indoor-industry/bike_voltage_regulator-rectifier/jlcpcb/production_files/BOM-bike_voltage_regulator-rectifier.csv

Comment | Designator | Footprint | LCSC | Quantity
0805G_(Green) | LED1 | LED0805-R-RD | C2297 | 1
100nF | C3,C4 | C_0805 | C28233 | 2
10kΩ | R3,R4 | R_0805 | C17414 | 2
10Ω | R13,R7 | R_0805 | C17415 | 2
17-21SUYC/TR8 | LED2 | LED0805-R-RD | C2296 | 1
2200uF_35V_16X25 | C1,C2 | CAP-TH_BD16.0-P7.50-D1.2-FD | C2763 | 2
22kΩ | R8 | R_0805 | C17560 | 1
22nF | C5 | C_0805 | C1729 | 1
3.3kΩ | R1 | R_0805 | C26010 | 1
4.7kΩ | R12,R6 | R_0805 | C17673 | 2
470kΩ | R10 | R_0805 | C17709 | 1
5.1kΩ | R11,R9 | R_0805 | C27834 | 2
BZT52C16-TP | D3 | SOD-123_L2.8-W1.8-LS3.7-RD | C668894 | 1
IRFB4110PBF | U2,U9 | TO-220-3_L10.0-W4.5-P2.54-L | C2650 | 2
LM2903DRG4 | U4 | SOIC-8_L5.0-W4.0-P1.27-LS6.0-BL | C7549 | 1
MBR2045CT_C173461 | U3 | TO-220AB-3_L10.4-W4.6-P2.54-T | C173461 | 1
MMBT3904 | U6 | SOT-23-3_L2.9-W1.3-P1.90-LS2.4-BR | C20526 | 1
MMBT3906LT1G | U7 | SOT-23-3_L2.9-W1.3-P1.90-LS2.4-BR | C53444 | 1
SMCJ16A-E3/57T | D1 | SMC_L6.9-W5.9-LS7.9-RD | C1976569 | 1
TL431BQDBZR | U1 | SOT-23-3_L2.9-W1.6-P1.90-LS2.8-BR | C190245 | 1
