indoor-industry/bike_voltage_regulator-rectifier/bike_voltage_regulator-rectifier.step

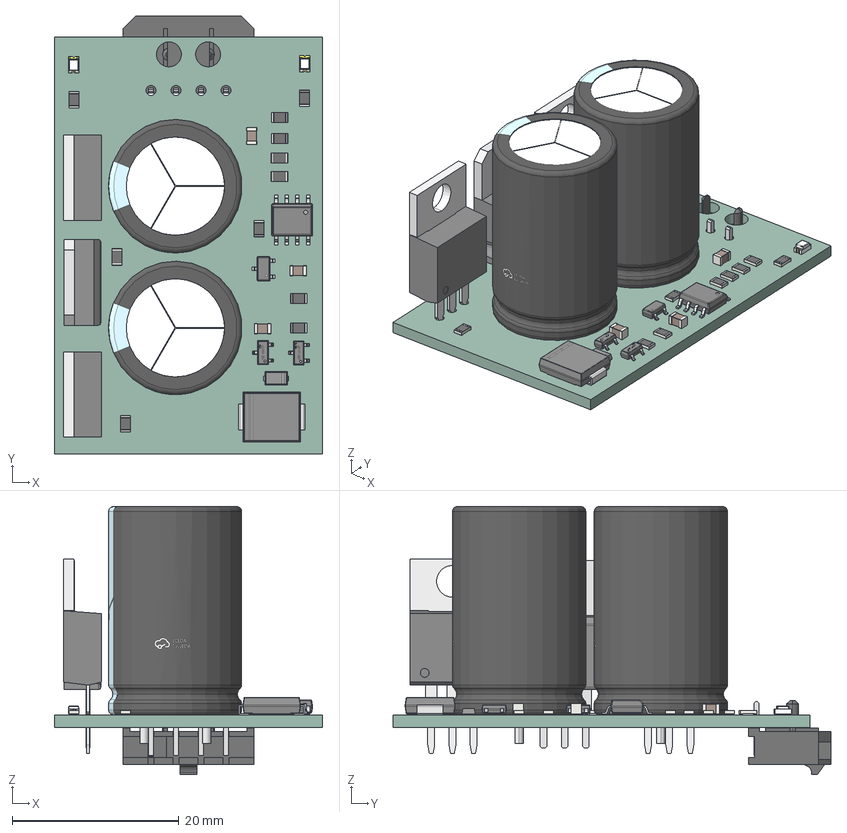
[picture p1: CAD file, 2026-10-28]
bike_voltage_regulator-rectifier.step
32.1 x 52.5 x 32.2 mm
R_0805_2012Metric x 11
SOT-23-3P_L2.9-W1.3-H1.0-LS2.4-P0.95 x 2
C_0805_2012Metric x 3
CAP-TH_D16.0-H25.0-P7.50 x 2
TO-220-3_L10.0-W4.5-P2.54-L x 2
SOIC-8_L4.9-W3.9-H1.7-LS6.0-P1.27
SMC_L6.9-W5.9-LS7.9-RD
LED0805-RD x 2
SOT-23-3L_L2.9-W1.6-H1.1-LS2.8-P0.95
SOD-123_L2.8-W1.8-LS3.7-RD
TO-220AB-3_L10.4-W4.6-H9.2-P2.54
CONN-TH_4P-P3.00_L8.9-W15.7-EH4.7
bike_voltage_regulator-rectifier_PCB
