indoor-industry/bike_voltage_regulator-rectifier/case/reg-rect_case-case.step

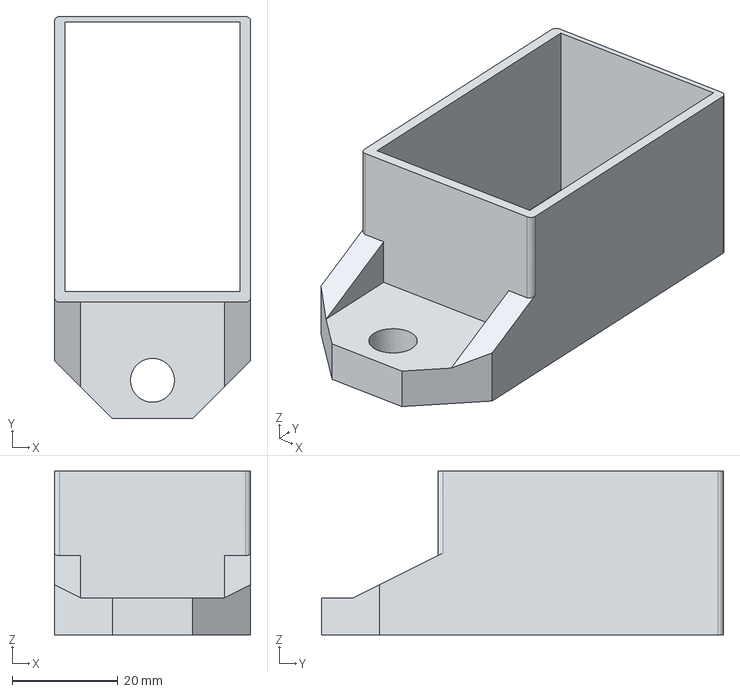
[picture p2: CAD file, 2026-10-12]
case/reg-rect_case-case.step
37.1 x 76.0 x 31.0 mm
