indoor-industry/bike_voltage_regulator-rectifier/case/reg-rect_case.FCStd

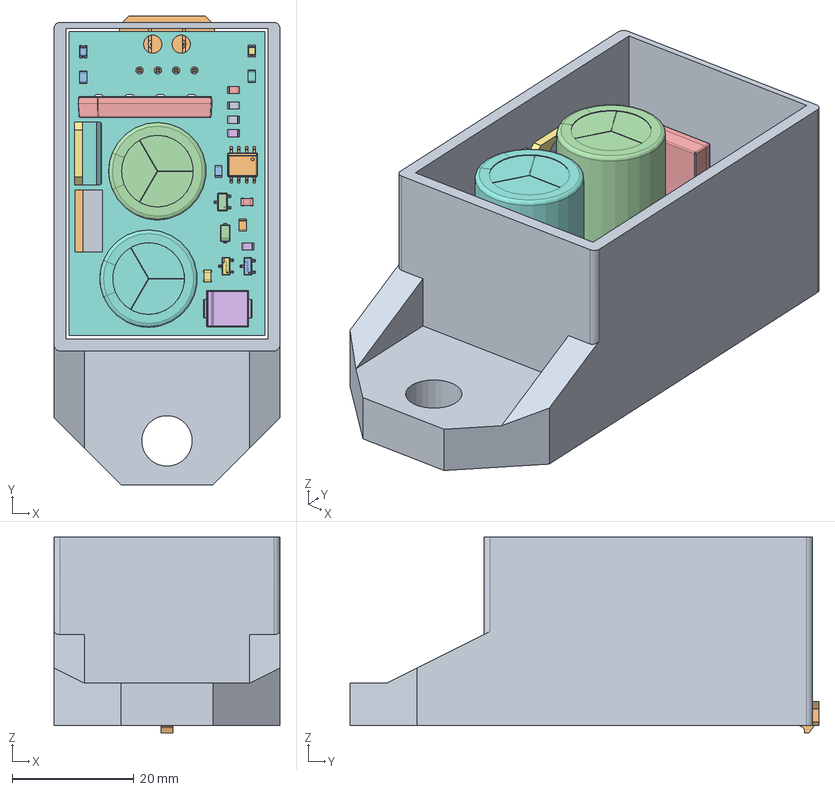
[picture p3: CAD file, 2026-10-12]
case/reg-rect_case.FCStd
37.1 x 77.0 x 32.2 mm
case
R_0805_2012Metric009
SOT-23-3P_L2.9-W1.3-H1.0-LS2.4-P0.036
SOT-23-3P_L2.9-W1.3-H1.0-LS2.4-P0.037
SOT-23-3P_L2.9-W1.3-H1.0-LS2.4-P0.038
SOT-23-3P_L2.9-W1.3-H1.0-LS2.4-P0.039
SOT-23-3P_L2.9-W1.3-H1.0-LS2.4-P0.040
SOT-23-3P_L2.9-W1.3-H1.0-LS2.4-P0.041
SOT-23-3P_L2.9-W1.3-H1.0-LS2.4-P0.042
SOT-23-3P_L2.9-W1.3-H1.0-LS2.4-P0.043
SOT-23-3P_L2.9-W1.3-H1.0-LS2.4-P0.044
SOT-23-3P_L2.9-W1.3-H1.0-LS2.4-P0.045
SOT-23-3P_L2.9-W1.3-H1.0-LS2.4-P0.046
SOT-23-3P_L2.9-W1.3-H1.0-LS2.4-P0.047
SOT-23-3P_L2.9-W1.3-H1.0-LS2.4-P0.048
SOT-23-3P_L2.9-W1.3-H1.0-LS2.4-P0.049
SOT-23-3P_L2.9-W1.3-H1.0-LS2.4-P0.050
SOT-23-3P_L2.9-W1.3-H1.0-LS2.4-P0.051
SOT-23-3P_L2.9-W1.3-H1.0-LS2.4-P0.052
SOD-123_L2.7-W1.6-LS3.7-RD-001
R_0805_2012Metric010
R_0805_2012Metric011
C_0805_2012Metric002
CAP-TH_D16.0-H25.0-P7.002
TO-220-3_L10.0-W4.5-P2.54-L004
TO-220-3_L10.0-W4.5-P2.54-L005
R_0805_2012Metric012
CAP-TH_D16.0-H25.0-P7.003
GBU_4P-L22.0-W3.5-P5.08_GBU810
R_0805_2012Metric013
SOT-23-3P_L2.9-W1.3-H1.0-LS2.4-P0.054
SOT-23-3P_L2.9-W1.3-H1.0-LS2.4-P0.055
SOT-23-3P_L2.9-W1.3-H1.0-LS2.4-P0.056
SOT-23-3P_L2.9-W1.3-H1.0-LS2.4-P0.057
SOT-23-3P_L2.9-W1.3-H1.0-LS2.4-P0.058
SOT-23-3P_L2.9-W1.3-H1.0-LS2.4-P0.059
SOT-23-3P_L2.9-W1.3-H1.0-LS2.4-P0.060
SOT-23-3P_L2.9-W1.3-H1.0-LS2.4-P0.061
SOT-23-3P_L2.9-W1.3-H1.0-LS2.4-P0.062
SOT-23-3P_L2.9-W1.3-H1.0-LS2.4-P0.063
SOT-23-3P_L2.9-W1.3-H1.0-LS2.4-P0.064
SOT-23-3P_L2.9-W1.3-H1.0-LS2.4-P0.065
SOT-23-3P_L2.9-W1.3-H1.0-LS2.4-P0.066
SOT-23-3P_L2.9-W1.3-H1.0-LS2.4-P0.067
SOT-23-3P_L2.9-W1.3-H1.0-LS2.4-P0.068
SOT-23-3P_L2.9-W1.3-H1.0-LS2.4-P0.069
SOT-23-3P_L2.9-W1.3-H1.0-LS2.4-P0.070
R_0805_2012Metric014
R_0805_2012Metric015
SOIC-8_L4.9-W3.9-H1.7-LS6.0-P1.001
R_0805_2012Metric016
SOT-23-3L_L2.9-W1.6-H1.1-LS2.8-P0.001
C_0805_2012Metric003
SMC_L6.9-W5.9-LS7.9-RD002
LED0805-RD010
LED0805-RD011
LED0805-RD012
LED0805-RD013
LED0805-RD015
LED0805-RD016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
