indoor-industry/bike_voltage_regulator-rectifier/bike_voltage_regulator-rectifier.kicad_pcb

## KiCad design bike_voltage_regulator-rectifier.kicad_pcb (2026-10-28)

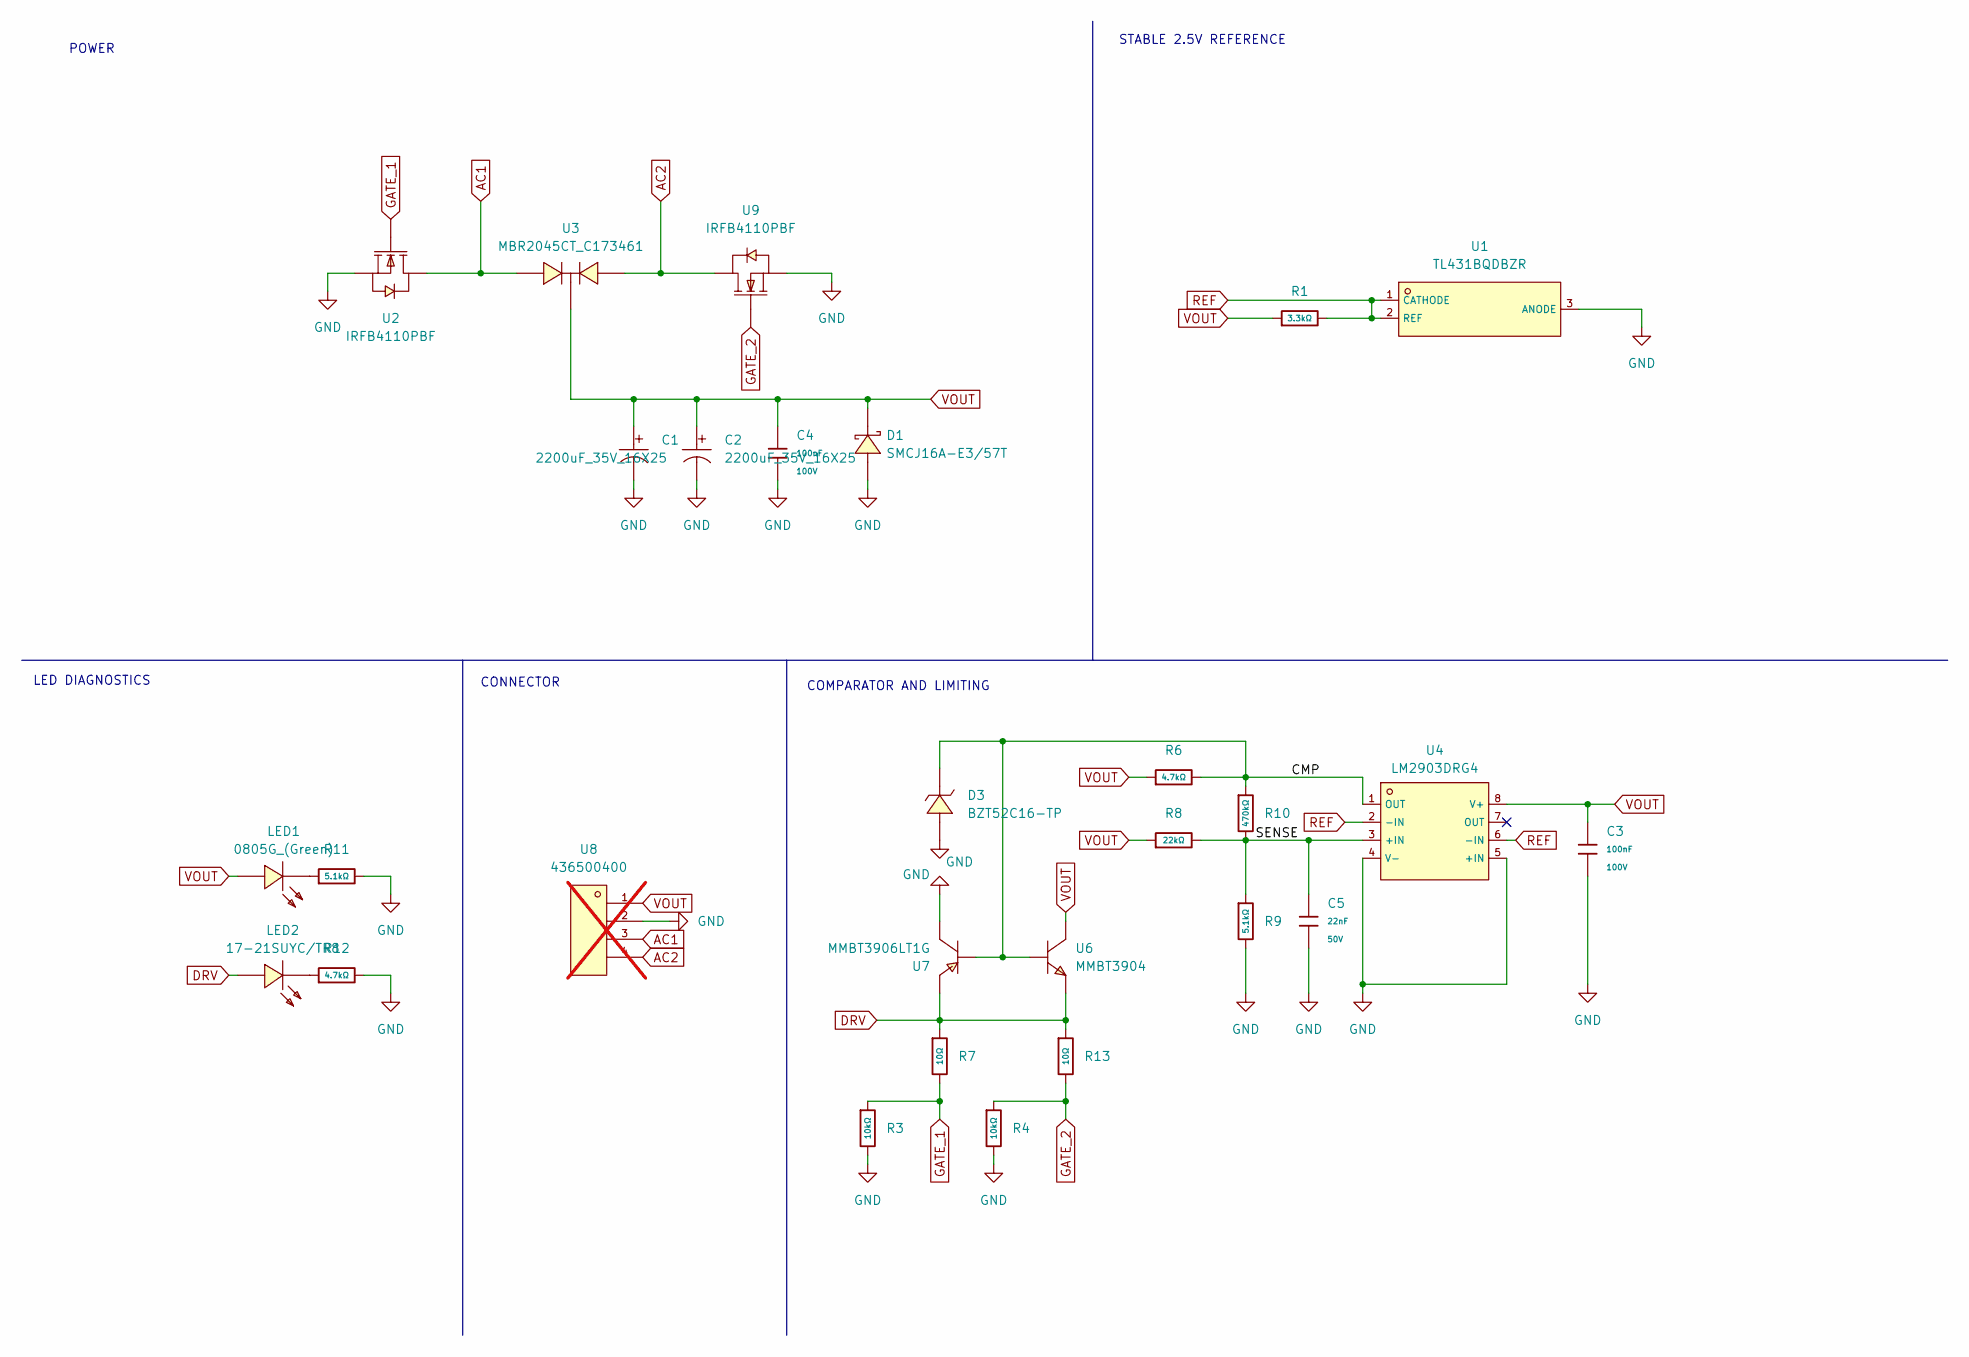
[picture p4: schematic bike_voltage_regulator-rectifier.kicad_sch]

Parts:
C1, C2: 2200uF_35V_16X25; CAP-TH_BD16.0-P7.50-D1.2-FD; LCSC C2763
C3, C4: 100nF; C_0805; Voltage Rated 100V; Tolerance ±10%; Part CL21B104KCFNNNE; LCSC C28233
C5: 22nF; C_0805; Voltage Rated 50V; Tolerance ±10%; Part CL21B223KBANNNC; LCSC C1729
D1: SMCJ16A-E3/57T; SMC_L6.9-W5.9-LS7.9-RD; LCSC C1976569
D3: BZT52C16-TP; SOD-123_L2.8-W1.8-LS3.7-RD; LCSC C668894
LED1: 0805G_(Green); LED0805-R-RD; LCSC C2297
LED2: 17-21SUYC/TR8; LED0805-R-RD; LCSC C2296
R1: 3.3kΩ; R_0805; Overload Voltage (Max) 150V; Tolerance ±1%; Part 0805W8F3301T5E; LCSC C26010
R3, R4: 10kΩ; R_0805; Overload Voltage (Max) 150V; Tolerance ±1%; Part 0805W8F1002T5E; LCSC C17414
R6, R12: 4.7kΩ; R_0805; Overload Voltage (Max) 150V; Tolerance ±1%; Part 0805W8F4701T5E; LCSC C17673
R7, R13: 10Ω; R_0805; Overload Voltage (Max) 150V; Tolerance ±1%; Part 0805W8F100JT5E; LCSC C17415
R8: 22kΩ; R_0805; Overload Voltage (Max) 150V; Tolerance ±1%; Part 0805W8F2202T5E; LCSC C17560
R9, R11: 5.1kΩ; R_0805; Overload Voltage (Max) 150V; Tolerance ±1%; Part 0805W8F5101T5E; LCSC C27834
R10: 470kΩ; R_0805; Overload Voltage (Max) 150V; Tolerance ±1%; Part 0805W8F4703T5E; LCSC C17709
U1: TL431BQDBZR; SOT-23-3_L2.9-W1.6-P1.90-LS2.8-BR; LCSC C190245
U2, U9: IRFB4110PBF; TO-220-3_L10.0-W4.5-P2.54-L; LCSC C2650
U3: MBR2045CT_C173461; TO-220AB-3_L10.4-W4.6-P2.54-T; LCSC C173461
U4: LM2903DRG4; SOIC-8_L5.0-W4.0-P1.27-LS6.0-BL; LCSC C7549
U6: MMBT3904; SOT-23-3_L2.9-W1.3-P1.90-LS2.4-BR; LCSC C20526
U7: MMBT3906LT1G; SOT-23-3_L2.9-W1.3-P1.90-LS2.4-BR; LCSC C53444
U8: 436500400; CONN-TH_4P-P3.00_L8.9-W15.7-EH4.7; LCSC C277684; not fitted

Connections:
/CMP: D3.1 (C), R6.2, R10.1, U4.1 (OUT), U6.1 (B), U7.1 (B)
/SENSE: C5.1, R8.2, R9.1, R10.2, U4.3 (+IN)
AC1: U2.2 (D), U3.1 (A), U8.3
AC2: U3.3 (A), U8.4, U9.2 (D)
DRV: LED2.1 (+), R7.1, R13.1, U6.2 (E), U7.2 (E)
GATE_1: R3.1, R7.2, U2.1 (G)
GATE_2: R4.1, R13.2, U9.1 (G)
GND: C1.2, C2.2, C3.2, C4.2, C5.2, D1.2 (A), D3.2 (A), R3.2, R4.2, R9.2, R11.2, R12.2, U1.3 (ANODE), U2.3 (S), U4.4 (V-), U4.5 (+IN), U7.3 (C), U8.2, U9.3 (S)
unnamed: LED1.2 (K), R11.1
unnamed: LED2.2 (-), R12.1
REF: R1.2, U1.1 (CATHODE), U1.2 (REF), U4.2 (-IN), U4.6 (-IN)
VOUT: C1.1, C2.1, C3.1, C4.1, D1.1 (K), LED1.1 (A), R1.1, R6.1, R8.1, U3.2 (C), U4.8 (V+), U6.3 (C), U8.1

Notes on the sheet:
STABLE 2.5V REFERENCE
CONNECTOR
POWER
LED DIAGNOSTICS
COMPARATOR AND LIMITING

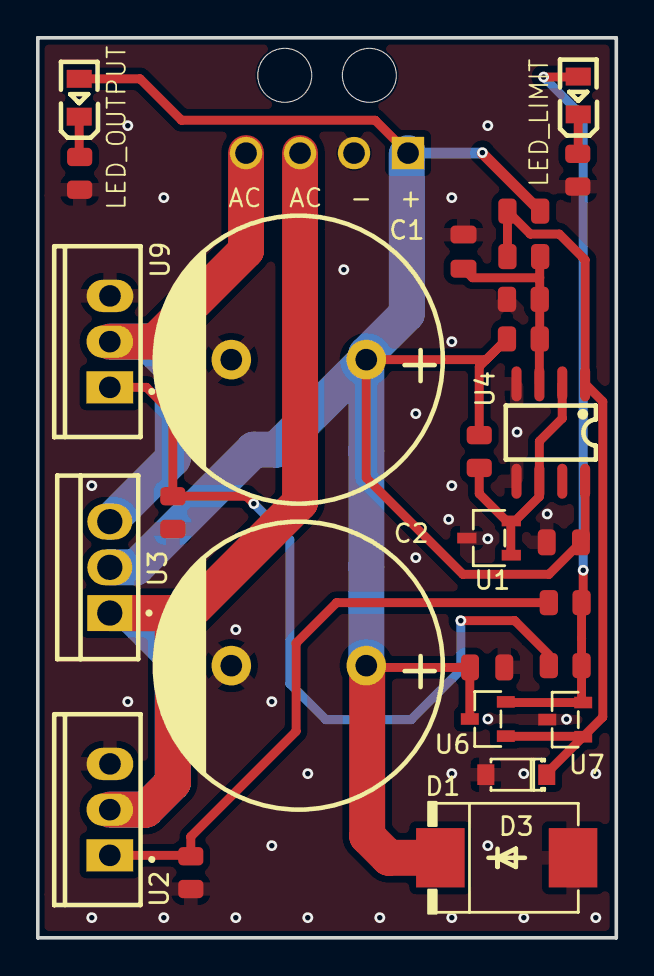
[picture p5: board bike_voltage_regulator-rectifier.kicad_pcb from above]

Board: 2 copper layers, 32.1 x 50.0 mm, 28 parts (1 on the bottom side), 12 nets.
