indoor-industry/bike_voltage_regulator-rectifier/(commit log)

2026-10-12 first prototype
    [BOM-bike_voltage_regulator-rectifier.csv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]
2026-10-12 case prototype also ready
    [reg-rect_case-case.step]
2026-10-28 Changed rectification architecture
    [BOM-bike_voltage_regulator-rectifier.csv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]
